AnMayVaa/Sentry/docs/NSC_Project_Report.md

# NSC 2026 Project Report: CSI Fall Detection System (Sentry)

This document tracks the progress, methodologies, conflicts, and engineering solutions for the Sentry project. It serves as a master log for the 28th National Software Contest (NSC) documentation.

---

## Phase 1: Hardware Setup & Data Extraction
**Goal**: Establish a stable Wi-Fi connection between two ESP32 modules and extract raw Channel State Information (CSI) subcarriers in real-time.

*   **Approach**: We configured the Transmitter (Tx) node to continuously inject 802.11 QoS Data packets at 30Hz using the connectionless ESP-NOW protocol. This forces the hardware to use the 54 Mbps OFDM rate, ensuring the radio waves physically contain the 52 usable CSI subcarriers. The Receiver (Rx) node listens in Promiscuous mode, filters by MAC address, and streams the payload over USB. A Python PyQt6 GUI was built to graph the wave amplitudes in real-time.
*   **Conflict**: The ESP32 Rx node kept crashing and rebooting with a `Task watchdog got triggered` error. 
*   **Solution**: The UART serial port at standard `115200` baud was too slow to print 52 floats at 30 frames per second, causing a buffer overflow. We solved this by forcing the UART baud rate to `460800` in both the `sdkconfig` and `rx_main.c` firmware, allowing high-speed, crash-free data streaming.

---

## Phase 2: Machine Learning Fall Detection
**Goal**: Train an Artificial Intelligence model to mathematically detect human falls using the invisible Wi-Fi radio waves.

*   **Approach**: We recorded three CSV datasets (`static.csv`, `walking.csv`, `falling.csv`). We built a feature extraction script (`train_model.py`) to slice the data into 1.5-second windows and calculate mathematical features (Variance, Standard Deviation, Rate of Change). We trained a Random Forest Classifier using `scikit-learn`.
*   **Conflict 1 (Physics)**: Initially, the AI classified falls as "Static". This happened because the physical fall was recorded *behind* the antenna's Line-of-Sight, meaning the Wi-Fi waves didn't hit the body. 
*   **Solution 1**: We re-recorded the falls directly between the two antennas, providing the AI with massive variance spikes.
*   **Conflict 2 (Data Labeling)**: The AI started predicting "Fall" when the user was just walking. This occurred because `falling.csv` contained seconds of walking and lying still, which corrupted the "Fall" label.
*   **Solution 2**: We engineered an automated Data Cleaner inside `train_model.py` that mathematically sorts the file and isolates *only* the top 15% highest-variance frames (the actual impact moment) to train the model, discarding the rest.
*   **Conflict 3 (UI Flickering)**: Quick hand shakes or jumps caused instant, false-positive "FALL DETECTED" flashes in the UI.
*   **Solution 3**: We implemented a **Temporal Sequence State Machine**. A real fall isn't just an impact—it's an impact *followed by stillness*. The app now detects the impact, flags a "Potential Fall", and waits. If the person continues moving, it's ignored. If the person lies completely still, it locks into a "CONFIRMED FALL". We also linked the UI Threshold slider to the AI, allowing the user to manually override sensitivity.

---

## Phase 3: Emergency Notification System
**Goal**: Instantly alert caregivers or family members when the State Machine confirms a fall, ensuring rapid medical response.

*   **Approach**: We integrated the **LINE Messaging API** because LINE is universally used by Thai families and requires no extra app installation. We engineered `line_notifier.py` to construct and send a "Flex Message"—a beautiful, red emergency UI card displaying the exact time of the fall and a primary button to instantly dial `1669` (Ambulance).
*   **Conflict**: If a person stays on the ground, the Python loop (running at 30 frames per second) would send thousands of API requests to LINE, resulting in a ban for spamming. Furthermore, making API requests blocks the main thread, causing the PyQT6 graphs to lag and freeze.
*   **Solution**: We executed the LINE notification inside a Python `threading.Thread(daemon=True)` so it runs in the background without interrupting the live graphs. We also implemented a 60-second software cooldown timer, ensuring the family receives exactly one clear alert per minute until the situation is resolved.

## Phase 4: Hardware SOS Panic Button
**Goal**: Allow elders to manually trigger an alert if they feel dizzy or sick, bypassing the AI fall detection entirely.

*   **Approach**: We hacked the physical `BOOT` button (GPIO 0) built into the Transmitter ESP32. When pressed, the ESP32 conditionally switches its standard ESP-NOW payload from "CSI_MAGIC" to a special "SOS_BUTTON_PRESSED!" string.
*   **Conflict**: The Receiver (Rx) node is strictly configured to run in Promiscuous Mode to sniff raw Wi-Fi waves for CSI extraction. However, in Promiscuous Mode, the ESP32 MAC layer completely blocks the ESP-NOW layer from receiving packets via the standard `espnow_recv_cb` callback. 
*   **Solution**: We bypassed the MAC layer restriction by using Physics! We reprogrammed the Transmitter to dynamically change its payload size. A normal CSI packet is small (~16 bytes). When the SOS button is pressed, the Transmitter instantly bloats its packet to 150 bytes. Inside the Receiver's raw CSI callback, we monitor `info->rx_ctrl.sig_len`. If a massive wave hits the antenna (>100 bytes), the Receiver instantly recognizes it as an SOS signal without needing to decode the payload, bypassing the ESP-NOW limitation entirely. The Rx node then pipes an "SOS_ALERT" string to the Python App, which forces the State Machine into a Fall State and triggers the LINE API. Furthermore, we programmed the Receiver's local BOOT button to instantly print the same `SOS_ALERT` string, meaning BOTH nodes now act as physical panic buttons.
*   **Conflict 2 (Software)**: The Python background thread silently crashed when parsing the `SOS_ALERT` because the UI callback function expected two mathematical arguments (amplitudes, RSSI), but was only given one string ("SOS").
*   **Solution 2**: We updated the background `SerialReader` thread in `serial_reader.py` to properly intercept the `SOS_ALERT` string and pass a dummy RSSI argument (`"SOS", 0`) to satisfy the UI callback's strict signature, instantly un-freezing the graph and firing the LINE API.

## Phase 1.5: Wireless UDP PC Receiver
**Goal**: Remove the USB cable entirely from the Receiver (Rx) Node, allowing it to send CSI data wirelessly over the home Wi-Fi network directly to the PC via UDP packets.

*   **Approach**: We re-wrote the Rx Node firmware in Arduino IDE to leverage its native Wi-Fi stack. The Rx node continues to use Promiscuous Mode on Channel 6 to sniff CSI from the Tx Node, but instead of streaming over serial, it connects to the home router (Access Point) and broadcasts UDP packets to the Windows PC on Port 5000. We also upgraded the Python PyQt6 GUI to replace `serial_reader.py` with a multi-threaded `udp_reader.py`.
*   **Conflict 1 (Build Environment)**: The manual Windows ESP-IDF terminal encountered strict `PATH` and Python environment alias errors when trying to flash the UDP C code, halting progress.
*   **Solution 1**: We abandoned the rigid ESP-IDF C++ environment for this phase and migrated the Rx Node entirely to an Arduino IDE `.ino` sketch. Because the ESP32 Arduino Core wraps the ESP-IDF natively, we could still import `<esp_wifi.h>` to access the low-level Promiscuous Mode and CSI callback functions, granting the user a frictionless 1-click GUI upload process.
*   **Conflict 2 (The One-Antenna Physics Problem)**: When we flashed the UDP code, the Arduino printed `CSI Sniffing Started!` but failed to receive a single packet from the Tx Node. This happened because the ESP32 only has *one* physical antenna. When `WiFi.begin()` connected the Rx Node to the home router to send UDP packets, the antenna forcibly tuned to the router's channel (e.g., Channel 11). Because the Tx Node was still transmitting on Channel 6, the Rx Node became physically deaf to the Tx Node.
*   **Solution 2**: We logged into the user's home TP-Link Router admin panel and forced the 2.4GHz Wi-Fi band to broadcast strictly on **Channel 6**. This aligned the router, the Tx Node, and the Rx Node on the exact same frequency, instantly restoring the invisible CSI radio wave flow.
*   **Conflict 3 (Type Casting & Mathematical Explosion)**: After solving the channel issue, the Python GUI successfully received UDP packets, but the Amplitude graph jumped violently between 100-300, causing the Variance logic to hit 120+ and constantly trigger false "MOVEMENT" alarms. This occurred because we accidentally defined the CSI payload buffer as `uint8_t` (unsigned) instead of `int8_t` (signed) in the Arduino struct. When the ESP32 printed a negative raw CSI value (e.g., `-5`), it wrapped around and was transmitted via UDP as a massive positive integer (`251`).
*   **Solution 3**: We corrected the struct definition in `Arduino_UDP_Receiver.ino` to use `int8_t buf[128]`. This allowed the `udp.print()` function to properly send negative numbers across the Wi-Fi network. The Python app immediately registered correct amplitudes (0-40) and Variance stabilized back to 0-5.
*   **Conflict 4 (Frame Rate Dilution)**: Even with correct amplitudes, the user had to move extremely aggressively for long periods to trigger a Fall or Movement state. This occurred because the ESP32 only has one physical antenna. In Phase 1.5, the RX Node was forced to rapidly switch its MAC layer between sniffing for CSI (Promiscuous Mode) and transmitting to the router (Station Mode) 30 times a second. Because of this massive transmission overhead, it dropped ~50% of the incoming CSI packets. This reduced the effective frame rate to 10-15 fps, causing the AI's mathematical 45-frame window to stretch from 1.5 seconds out to over 3 seconds, artificially diluting the Standard Deviation (Variance) of quick human movements.
*   **Solution 4**: We implemented a **UDP Packet Batching Optimization** in `Arduino_UDP_Receiver.ino`. Instead of transmitting one UDP packet for every CSI frame received, the ESP32 now queues 5 CSI frames into a memory buffer and transmits them together inside a single UDP packet separated by newline characters (`\n`). This cut the Wi-Fi transmission overhead by 500%, allowing the ESP32 to spend 95% of its airtime listening for CSI. We then upgraded the Python `udp_reader.py` to seamlessly parse multi-line UDP packets. This fully restored the 30Hz frame rate and the hyper-responsiveness of the ML model without requiring hardware upgrades.

## Phase 1.75: Edge-Compute Central Brain & Cloudflare Deployment
**Goal**: Migrate the heavy Machine Learning inference and UI rendering off the local PC and onto a headless Raspberry Pi 5 Edge Server, making the dashboard accessible globally via the internet.

*   **Approach**: We deployed the ESP32 receiver via USB directly to the Raspberry Pi 5. We wrote `headless_brain.py` to act as a Unified Server, binding a Python `http.server` and `websockets` engine to a single port (`8000`). We built a stunning Glassmorphism HTML dashboard (`index.html`) using `Chart.js` to render live data over WebSockets. We then deployed a persistent Docker container running `cloudflare/cloudflared` to expose port `8000` globally through a Cloudflare Tunnel (`csi.ohmpatumwan.com`).
*   **Conflict 1 (Tunnel Gateway Crash)**: When setting up the Cloudflare Tunnel, the Cloudflare dashboard reported the tunnel was "Healthy," but accessing the URL resulted in a `502 Bad Gateway`. This occurred because the `cloudflared` process was running inside an isolated Docker container and attempting to route traffic to `http://localhost:8000`. Since the Docker container has its own isolated network stack, its `localhost` could not reach the Raspberry Pi's host network where the Python server was running.
*   **Solution 1**: We destroyed the container and re-deployed it with the `--network host` flag. This bound the container directly to the Raspberry Pi's physical network stack, allowing the tunnel to successfully bridge internet traffic to the Python application.
*   **Conflict 2 (Web Browser Graphics Lag)**: When the dashboard loaded, the `Chart.js` graphs rendered, but the web browser experienced intense stuttering, micro-pausing, and graphic lag on all devices. This occurred because the Raspberry Pi was aggressively blasting 30 JSON payloads per second over the Cloudflare tunnel, and `Chart.js` attempted to mathematically calculate animation curves between every single incoming data point, completely overloading the browser's rendering thread.
*   **Solution 2**: We implemented a dual-layer optimization. On the backend, we introduced a 15 FPS throttle in the Python WebSocket broadcasting loop, ensuring the ML model continues to process physics internally at 30Hz but only sends UI updates every 0.06 seconds. On the frontend, we injected a hardware-acceleration bypass (`chart.update('none')`) into `Chart.js`, forcefully disabling the heavy animation loop and drawing the raw pixels instantly.
*   **Conflict 3 (Responsive Layout Destruction)**: Viewing the Glassmorphism dashboard on mobile devices or zooming in on a desktop caused extreme layout clipping. The CSS architecture was rigidly locked to `height: 100vh` and `overflow: hidden`, breaking the 52-subcarrier charts and warping the control cards into a giant column of wasted space on iPads.
*   **Solution 3**: We unlocked the main CSS container to `min-height: 100vh`, enabled `overflow-x: auto` on the charts to allow physical swiping/sliding, and added specific `@media` breakpoints. This forces the control cards to densely stack without rigid flex-basis padding, creating a flawless, scrollable experience tailored for iPhones and iPads.
*   **Conflict 4 (Multi-Device Desynchronization & Latency)**: We built a Two-Way hardware control panel in the UI (Connect/Disconnect toggle). However, if a user clicked "Disconnect" on their iPad, their PC dashboard remained frozen with the "Connected" UI state. Furthermore, there was an awkward 1-2 second UI delay when pressing the Connect button because the UI waited for Python to physically initialize the PySerial COM port.
*   **Solution 4**: We completely re-architected the Python backend's state architecture. We programmed a global `broadcast_config()` coroutine that instantly pushes state changes to every single connected WebSocket client (`self.connected_clients`). Now, toggling a setting on a phone perfectly mirrors the update to the desktop instantly. Additionally, we injected Optimistic UI Updates into the frontend. When the user taps a button, it instantly fades out and displays "Connecting...", providing immediate tactile feedback while the backend safely completes the physical hardware negotiation.

## Phase 2: Universal Brain (Wireless UDP & mDNS Auto-Discovery)
**Goal**: Completely eliminate the physical USB cable restriction, allowing the ESP32 Receiver Node to be placed anywhere in the house while still streaming high-speed CSI data to the Raspberry Pi Edge Server.

*   **Approach**: We engineered a "Universal Dashboard" and "Universal ESP32 Firmware." The `headless_brain.py` backend was upgraded to dynamically hot-swap between reading from a physical USB `SerialReader` and a network `UDPReader`. The web dashboard was upgraded with a sleek Mode Switcher pill, allowing the user to seamlessly toggle between [USB Mode] and [Wireless UDP Mode] on the fly without dropping the WebSocket connection.
*   **Conflict 1 (Hardcoded IP Address Risk)**: Initially, the ESP32 Firmware was hardcoded to blast UDP packets to the Raspberry Pi's IP address (`192.168.1.8`). However, if the home router restarted and DHCP assigned a new IP to the Pi, the ESP32 would blast packets into the void, completely breaking the system.
*   **Solution 1**: We implemented an **mDNS (Multicast DNS) Auto-Discovery Resolver** using `<ESPmDNS.h>`. Upon boot, the ESP32 queries the local network for the Raspberry Pi's hostname (`OhmPatumwan.local`). Once the Pi responds, the ESP32 dynamically locks onto its current IP address and begins streaming. This makes the ESP32 permanently immune to DHCP IP changes.
*   **Conflict 2 (Firmware Fragmentation)**: Switching between Phase 1.75 (USB) and Phase 2 (UDP) required the user to constantly open the Arduino IDE and re-flash the ESP32 microcontroller with different codebases.
*   **Solution 2**: We engineered a **Universal Firmware** (`Arduino_UDP_Receiver.ino`). The ESP32 now processes the high-speed CSI packets and simultaneously prints them to the physical USB serial port AND blasts them over the Wi-Fi UDP network at the exact same time. The user flashes the ESP32 one final time, after which the hardware permanently supports both modes.

## Phase 3: "God Firmware", Home Router TX & Zero-Lag Architecture
**Goal**: Integrate a Home Router as the primary Wi-Fi wave transmitter to eliminate the need for a dedicated TX ESP32, and mathematically optimize the full pipeline to achieve zero-lag, 30fps real-time inference.

*   **Approach**: We developed the `Phase3_Router_as_TX` pipeline, which repurposes the existing home Wi-Fi router to blanket the room with OFDM Wi-Fi waves. The ESP32 (flashed with `Phase3_God_Firmware.ino`) passively sniffs these ambient waves. The Python backend stimulates the router by sending persistent UDP pings over Wi-Fi.
*   **Conflict 1 (ESP32 Serial Bottleneck)**: The system experienced extreme processing lag (~167ms delays). The ESP32 was artificially queueing CSI packets, and its blocking `Serial.print()` character-by-character UART output completely bottlenecked the CPU.
*   **Solution 1**: We refactored the ESP32 firmware into the "God Firmware". We stripped out the packet-batching delay and replaced the slow `Serial.print()` loop with an ultra-efficient, single-call `Serial.write()` that dumps a pre-formatted memory buffer instantly. This reduced hardware latency to near-zero.
*   **Conflict 2 (Python ML Hot-Path Overhead)**: The Raspberry Pi's ML inference fell further and further behind real-time, accumulating an infinite backlog of unprocessed frames. This occurred because the `headless_brain.py` hot-path created and destroyed Pandas `DataFrame` objects 30 times a second.
*   **Solution 2**: We completely eliminated Pandas from the real-time loop. We engineered `extract_features_np` to perform high-speed math directly on native NumPy arrays, and implemented a thread-safe frame-dropping mechanism (`self._processing` lock) that intelligently skips frames instead of queuing them, ensuring the ML model never falls behind real-time.
*   **Conflict 3 (Browser Render Jank)**: The web dashboard lagged and stuttered because `Chart.js` tried to forcefully repaint the DOM on every single incoming WebSocket message (30Hz).
*   **Solution 3**: We implemented a frame-buffering system in JavaScript. The incoming WebSocket data is decoupled from the UI thread, and we utilize the browser's native `requestAnimationFrame` API to batch chart updates smoothly into the hardware vsync cycle (60fps).
*   **Conflict 4 (NumPy JSON Serialization Crash)**: The Python WebSocket server would sporadically crash and systemd would auto-restart it, causing the dashboard to continuously disconnect and reconnect. The `scikit-learn` Random Forest prediction returned a NumPy `int32` datatype, which standard Python `json.dumps()` could not serialize.
*   **Conflict 5 (Chart.js Memory Leak)**: If the dashboard was left open for long periods, the web browser gradually consumed excessive RAM, causing intense Garbage Collection (GC) pauses and frontend lag.
*   **Solution 5**: We isolated the leak to the 52-subcarrier graph updates. Chart.js was destroying and recreating 52 internal `_meta` DOM objects 15 times a second because we assigned a brand new array reference each frame. We refactored the JavaScript to mutate the existing array in-place (`rawData[i] = new_value`), allowing Chart.js to infinitely recycle its objects, achieving zero memory buildup.

## Phase 4: Multi-Node Architecture & Stability Overhaul
**Goal**: Upgrade the single-room architecture to support an infinite number of Receiver (RX) Nodes across an entire house (e.g., Living Room, Bath Room), scaling the dashboard to visualize and process multi-room CSI data concurrently.

*   **Approach**: We re-architected `headless_brain.py` and the `dashboard/index.html` UI to operate dynamically using a `activeNodes` dictionary instead of hardcoded single-instance elements, allowing the UI to mathematically scale to however many ESP32s are connected. 
*   **Conflict 1 (Data Merging)**: Connecting two ESP32s resulted in their data completely overwriting and colliding with each other on the dashboard. This occurred because both boards output the identical hardcoded `Location: Bath Room` string in their Arduino C++ print statements.
*   **Solution 1**: We implemented a unique ID wrapper in the backend. When raw data enters Python, the `data_received` function dynamically prefixes the payload string with the physical interface ID (e.g. `[COM3]` or `[UDP_5000]`). This allowed the system to logically separate the physics of the two identical boards into two distinct UI blocks without requiring the user to re-flash the hardware firmware with custom names.
*   **Conflict 2 (Zombie Chart Memory Leak)**: If an ESP32 disconnected, its block disappeared. However, when it reconnected, the line graph flickered wildly and drew lines backward. This occurred because destroying the HTML block did not clear the underlying `Chart.js` canvas context from the browser's memory, creating "Zombie Charts" that cross-wired new incoming data with old data.
*   **Solution 2**: We wrapped the HTML rendering into a structured JavaScript `NodeCard` class. We added a strict `destroy()` method that explicitly purges the `Chart.js` object before deleting the HTML node, permanently preventing memory corruption upon reconnection.
*   **Conflict 3 (ESP32 Network Fragmentation & Crashes)**: Over long periods, the nodes exhibited extreme lag (causing the "Temporal Variance" UI number to stutter) and occasionally disappeared from the dashboard entirely. This occurred because the Python backend was constantly broadcasting "PING" strings to the ESP32's listening UDP port to stimulate the network. The poor microcontrollers were receiving 10 UDP packets a second, which fragmented their small heaps as they attempted to parse them, causing lag and eventual memory crashes.
*   **Solution 3**: We stripped the destructive PING command from the codebase. Instead, we directed the Python script to blindly broadcast an empty pulse to a null port (`5001`) over the entire subnet `255.255.255.255`. This successfully forces the Home Router to emit Wi-Fi traffic without burdening the ESP32s, resulting in flawless 24/7 stability.
*   **Conflict 4 (UDP Mode Blindness)**: When connecting multiple ESP32s over UDP, the user had to manually toggle the UI "Transmitter Target" button back and forth to get the ESP32s to configure themselves. This occurred because Python's `udp_reader.py` did not know the IP address of the newly connected ESP32s until *after* they had successfully sent their first packet, making it impossible to send them the initial configuration command.
*   **Solution 4**: We upgraded the UDP command delivery system to use Socket Subnet Broadcasting. When the user connects, Python now shouts the command configuration (`MODE_ROUTER` or `MODE_TX_NODE`) to `255.255.255.255`. Any ESP32 on the network instantly receives and configures itself without needing to establish a prior handshake, creating a zero-friction connection experience.
*   **Conflict 5 (Variance Graph Clipping)**: The Variance Chart completely broke (appearing blank or not updating) when the user made a large movement. This was simply because the Chart.js Y-Axis ceiling was hardcoded to `max: 20`. If the physics variance spiked to 50, the line was physically drawn off-screen.
*   **Solution 5**: We migrated the rigid `max: 20` parameter to `suggestedMax: 20`. This ensures the chart stays perfectly scaled during static periods, but dynamically expands its visual boundaries if violent movements occur, guaranteeing the blue line is always visible.
*   **Conflict 6 (Global Shared Limitations)**: The single "Sensitivity Threshold" slider applied uniformly to all rooms. A high threshold in a small Bath Room might be appropriate, but it ruined the detection algorithm for a massive Living Room.
*   **Solution 6**: We stripped the global slider from the top control panel. We injected a miniature HTML range slider into the `NodeCard` template itself. We then bound these UI sliders to a dedicated `threshold` variable inside the Python `NodeState` dictionary. Now, every single room/ESP32 has a strictly isolated AI trigger threshold that can be perfectly tuned to its physical environment.
*   **Conflict 7 (Hardware Connection Polling)**: The dashboard required a manual refresh to detect newly plugged-in USB COM Ports.
*   **Solution 7**: We injected an asynchronous `_poll_com_ports` background thread into `headless_brain.py` that queries `serial.tools.list_ports` every 2 seconds. When it detects a hardware state change, it automatically fires a WebSocket config payload to the dashboard, providing an instant, real-time "hot plug" UI experience.

---
*Document will be updated as new phases are completed.*
