AnMayVaa/Sentry/Phase8_Next_Phase/previews/overview/index.html

Wi-Fi fall detector · next phase

# A fall or an SOS now rings in every room.

Phase 8 adds a caregiver alert station, a hold-to-SOS button on the RX node, and printable boxes for both. A fall still sends a LINE card. Now the caregiver also hears it in the house.

2 shold the button for SOS

Allstations ring at once

0Pi needed for an SOS to ring

RX node box with antenna, button and LED

RX node

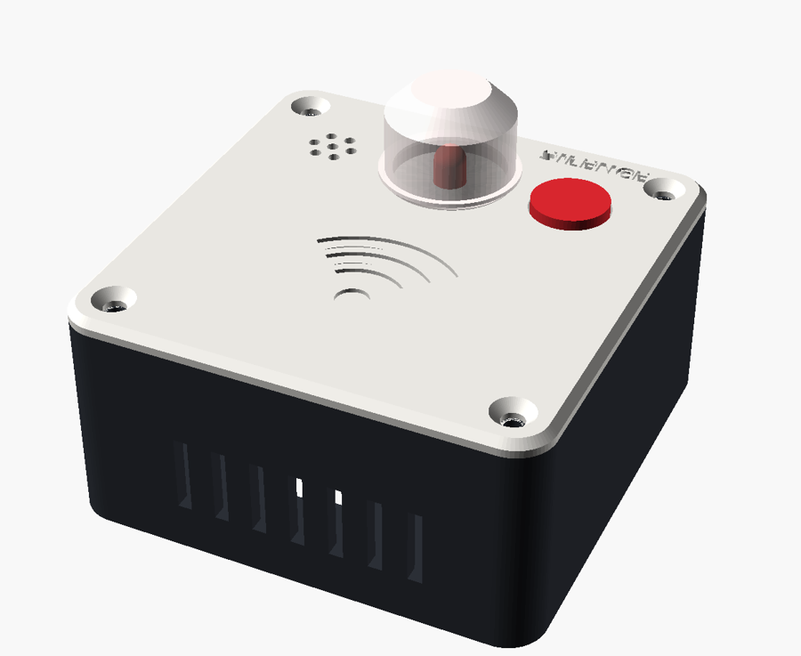
[picture p1: Phase8_Next_Phase/previews/overview/alert_station_assembled.png]
Alert station box with light dome and button


Alert station

## How an alert travels

## FALL When someone falls

1. The RX node streams Wi-Fi CSI to the Pi about 30 times a second.
2. The Pi's model sees the impact, then stillness, and calls it a fall.
3. The caregiver gets the red LINE fall card with Call 1669 and Silence.
4. Every alert station and the RX node start fast beeping until silenced.

## SOS When someone needs help

1. They hold the RX button for 2 seconds. The LED lights while they hold.
2. 3 quick chirps confirm it went out. The node sends it 3 times in case a packet drops.
3. The alert stations play SOS in Morse, straight from the node.
4. The Pi sends a separate 🆘 LINE card and the dashboard shows SOS PRESSED!

## What the button does

Device | When | Press | Result
RX node | Idle | Hold 2 s | SOS to Pi and stations
| Idle | Short | Status chirp (1 = Wi-Fi OK)
| Ringing | Any | Silences this node at once; no SOS
Alert station | Ringing | Any | Silences this station
| Idle | Hold 2 s | Self-test beep
| Idle | Short | Status chirp

## What each sound means

bars drawn to scale · 1.6 s shown

## Wiring (same on both devices)

GPIO 2 ──[220 Ω]──▶|── GND red LED GPIO 4 ──── (+) buzzer (–) ── GND active buzzer GPIO 17 ──── button ──── GND 12×12 switch (internal pull-up)

220 Ω gives the LED about 6 mA. For a louder buzzer in a noisy hall, drive it from 5 V through an S8050 transistor with a 1 kΩ base resistor.

## Antennas

Board

ESP32-WROOM-32U (IPEX socket)

RX node

2.4 GHz antenna outside on SMA: helps CSI sensing

Alert station

no outside antenna; keep the small one plugged in inside

Why inside

a 32U has no built-in antenna, so it needs one to join Wi-Fi

Option

alert_station_base_antenna_hole.stl if you want it outside

## The boxes

Size

72.8 × 72.8 × 35.8

mm, same for both devices, so one stand and one screw set fit both

Print

PLA or PETG · 0.2 mm layers · 3 walls · 20 % infill · no supports · fits a 220 mm bed

Mount

Table (rubber feet) · wall (2 keyholes, 32 mm apart) · 20° desk stand · tape

No brand name on any part: the lid only carries a Wi-Fi mark and the button label. Turn the boxes around in the 3D viewer.

35 / 35

### Pi tests

SOS copies count once, SOS never blocks a fall alert, both message formats parse.

31 / 31

### Firmware tests

The real sketches run on a PC with simulated buttons, buzzer, time and Wi-Fi.

9 / 9

### Print files checked

Closed and manifold, no supports, and no parts collide when assembled.

## Demo-day run

- Power the Pi, then the stations, then the RX node. Each beeps twice on Wi-Fi.
- Hold the RX button 2 s: chirps, Morse on the stations, LINE SOS card.
- Press each button to silence it.
- Do a fall: fast beeps everywhere and the LINE fall card. Tap Silence.
- Unplug the Pi and hold the RX button again: the stations still ring.

## Before you print and flash

- Compile both sketches once in the Arduino IDE (ESP32 core 3.x).
- Measure the ESP32 board: the box expects 52 × 28.5 mm.
- Print one lid first and check the button and LED fit.
- Put your Wi-Fi in secrets.h; it never goes to GitHub.
