AnMayVaa/Sentry/docs/images/CSI_Signal_Signatures.png

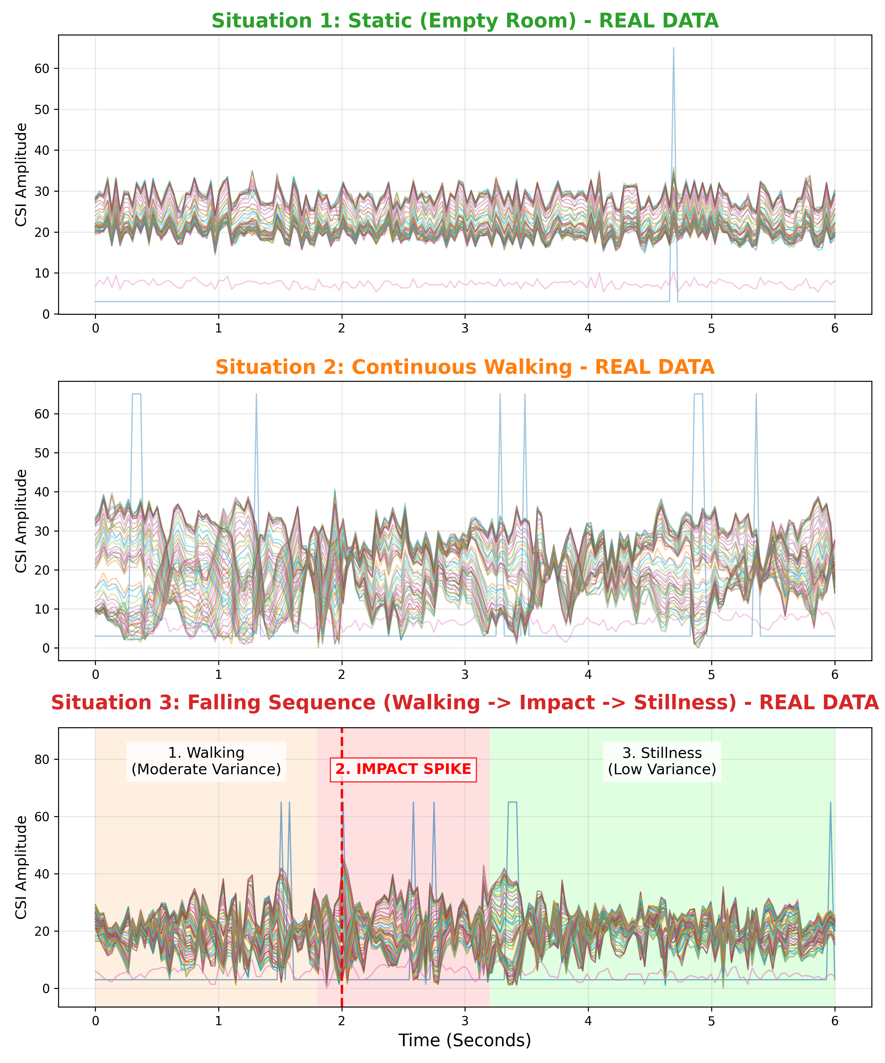
docs/images/CSI_Signal_Signatures.png
