AnMayVaa/Sentry/docs/images/image8_signature.png

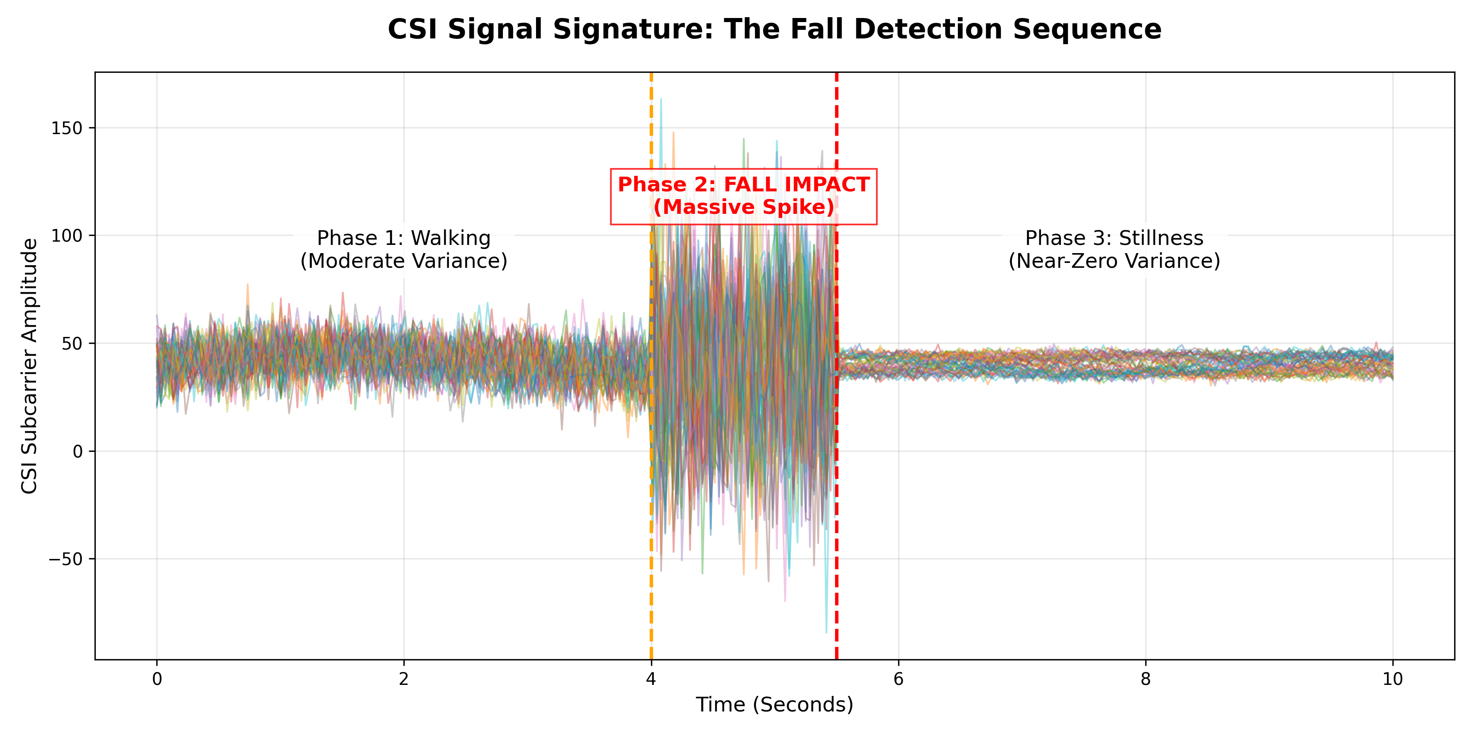
docs/images/image8_signature.png
