AnMayVaa/Sentry/docs/images/LINE_Mockup_1669.png

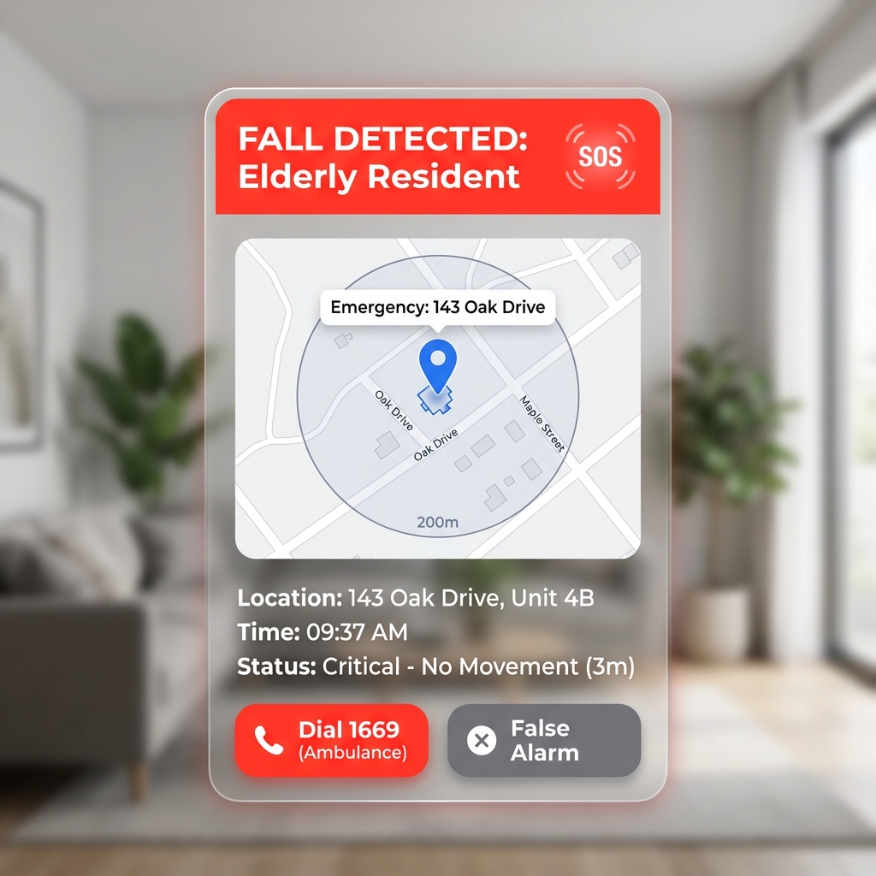
docs/images/LINE_Mockup_1669.png
