AnMayVaa/Sentry/Phase8_Next_Phase/enclosures/png/rx_node_exploded.png

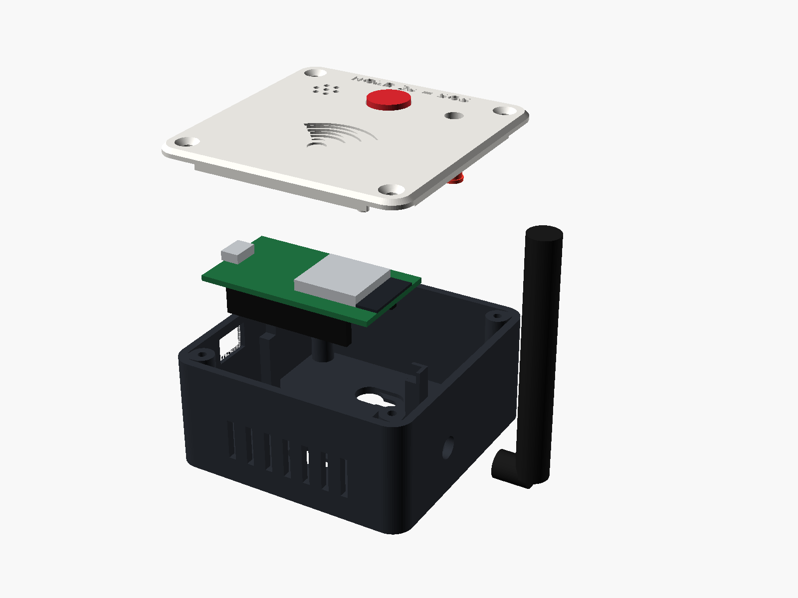
Phase8_Next_Phase/enclosures/png/rx_node_exploded.png
