AnMayVaa/Sentry/Phase8_Next_Phase/enclosures/stl/button_shim_1mm.stl

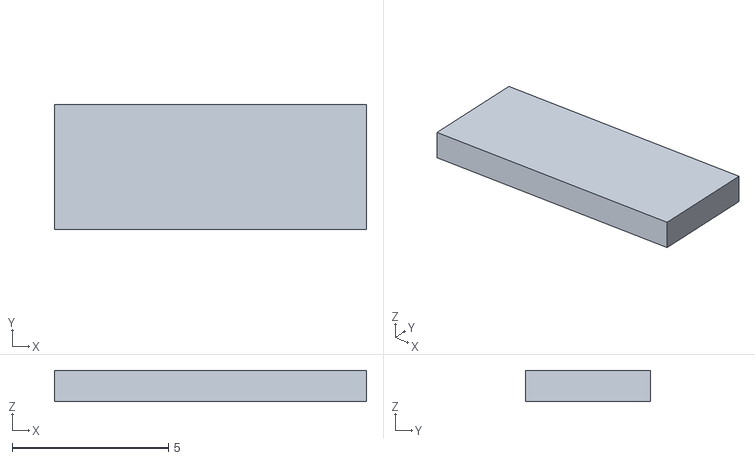
[picture p6: CAD file, 2026-11-09]
Phase8_Next_Phase/enclosures/stl/button_shim_1mm.stl
10.0 x 4.00 x 1.00
