AnMayVaa/Sentry/Phase8_Next_Phase/enclosures/stl/rx_node_lid.stl

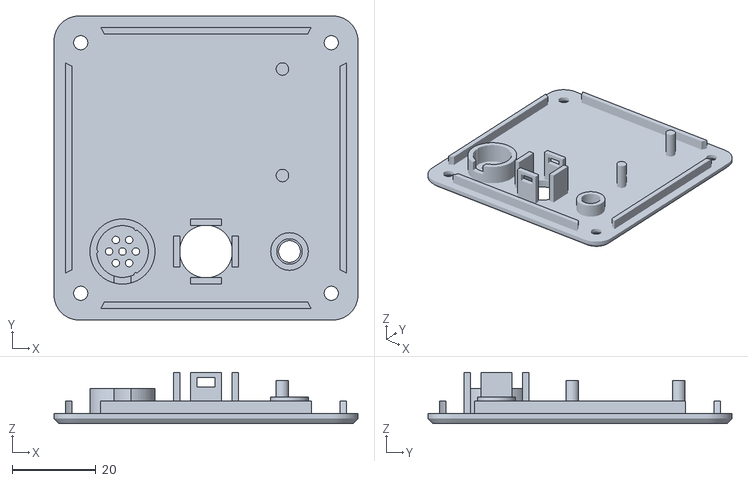
[picture p7: CAD file, 2026-11-09]
Phase8_Next_Phase/enclosures/stl/rx_node_lid.stl
72.8 x 72.8 x 12.3
