AnMayVaa/Sentry/Sentry_NSC_sourcecode/main.py

import sys
import locale
locale.setlocale(locale.LC_ALL, 'C') # Force English numerals

print("Starting main.py")
try:
    from PyQt6.QtWidgets import QApplication, QMainWindow, QVBoxLayout, QHBoxLayout, QWidget, QPushButton, QComboBox, QLabel, QGroupBox, QCheckBox
    from PyQt6.QtCore import QTimer
    import pyqtgraph as pg
    import numpy as np
    import serial.tools.list_ports
    from serial_reader import SerialReader
    from udp_reader import UDPReader
    print("Imported everything")
except Exception as e:
    print(f"Import error: {e}")
    sys.exit(1)

class CSIVisualizerApp(QMainWindow):
    def __init__(self):
        super().__init__()
        self.setWindowTitle("CSI Fall Detection Control App")
        self.resize(1000, 600)
        
        self.reader = None
        self.latest_data = None
        self.ml_model = None
        self.line_alerts_enabled = True
            
        self.prediction_history = []
        self.fall_latch_time = 0
        
        self.variance_buffer_size = 300 # 10 seconds at 30fps
        self.variance_history = np.zeros(self.variance_buffer_size)
        
        self.init_ui()
        
        # Timer for UI updates
        self.timer = QTimer()
        self.timer.timeout.connect(self.update_plot)
        self.timer.start(30) # ~33fps refresh rate
        
    def init_ui(self):
        from PyQt6.QtWidgets import QDoubleSpinBox, QGroupBox, QFrame
        from PyQt6.QtCore import Qt
        
        central_widget = QWidget()
        self.setCentralWidget(central_widget)
        main_layout = QHBoxLayout(central_widget)
        
        # --- LEFT PANEL: CONTROLS ---
        left_panel = QVBoxLayout()
        
        # 1. Connection Group
        conn_group = QGroupBox("1. Hardware Connection")
        conn_group.setStyleSheet("QGroupBox { font-weight: bold; }")
        conn_layout = QVBoxLayout()
        
        type_row = QHBoxLayout()
        type_row.addWidget(QLabel("Type:"))
        self.type_combo = QComboBox()
        self.type_combo.addItems(["Serial (COM)", "UDP (Wi-Fi)"])
        self.type_combo.currentTextChanged.connect(self.on_type_changed)
        type_row.addWidget(self.type_combo)
        conn_layout.addLayout(type_row)
        
        port_row = QHBoxLayout()
        self.lbl_port = QLabel("COM Port:")
        port_row.addWidget(self.lbl_port)
        self.port_combo = QComboBox()
        self.refresh_ports()
        port_row.addWidget(self.port_combo)
        
        self.btn_refresh = QPushButton("Refresh")
        self.btn_refresh.clicked.connect(self.refresh_ports)
        port_row.addWidget(self.btn_refresh)
        conn_layout.addLayout(port_row)
        
        self.btn_connect = QPushButton("Connect Receiver")
        self.btn_connect.setMinimumHeight(35)
        self.btn_connect.setStyleSheet("background-color: #2980b9; color: white; font-weight: bold; border-radius: 4px;")
        self.btn_connect.clicked.connect(self.toggle_connection)
        conn_layout.addWidget(self.btn_connect)
        
        self.lbl_status = QLabel("Status: Disconnected")
        self.lbl_status.setAlignment(Qt.AlignmentFlag.AlignCenter)
        conn_layout.addWidget(self.lbl_status)
        conn_group.setLayout(conn_layout)
        left_panel.addWidget(conn_group)
        
        # 2. Experiment / Recording Group
        rec_group = QGroupBox("2. Data Collection")
        rec_group.setStyleSheet("QGroupBox { font-weight: bold; }")
        rec_layout = QVBoxLayout()
        
        self.btn_record = QPushButton("Start Recording CSV")
        self.btn_record.setMinimumHeight(35)
        self.btn_record.clicked.connect(self.toggle_recording)
        self.btn_record.setEnabled(False)
        self.is_recording = False
        rec_layout.addWidget(self.btn_record)
        rec_group.setLayout(rec_layout)
        left_panel.addWidget(rec_group)
        
        # 3. AI Monitor Group
        ai_group = QGroupBox("3. AI Fall Detection Monitor")
        ai_group.setStyleSheet("QGroupBox { font-weight: bold; }")
        ai_layout = QVBoxLayout()
        
        thresh_row = QHBoxLayout()
        thresh_row.addWidget(QLabel("Variance Threshold:"))
        self.spin_threshold = QDoubleSpinBox()
        self.spin_threshold.setRange(0.1, 20.0)
        self.spin_threshold.setSingleStep(0.1)
        self.spin_threshold.setValue(2.0)
        self.current_threshold = 2.0
        self.spin_threshold.valueChanged.connect(self.update_threshold)
        thresh_row.addWidget(self.spin_threshold)
        ai_layout.addLayout(thresh_row)
        
        self.history = []
        self.is_moving = False
        
        self.lbl_movement = QLabel("STATIC")
        self.lbl_movement.setAlignment(Qt.AlignmentFlag.AlignCenter)
        self.lbl_movement.setStyleSheet("background-color: #27ae60; color: white; font-size: 22px; font-weight: bold; padding: 15px; border-radius: 5px;")
        ai_layout.addWidget(self.lbl_movement)
        ai_group.setLayout(ai_layout)
        left_panel.addWidget(ai_group)
        
        # Quick Guide
        guide_label = QLabel(
            "<h3>Quick Guide</h3>"
            "<ul>"
            "<li><b>Connect</b> to the RX node (ESP32).</li>"
            "<li><b>Threshold:</b> Controls sensitivity between Static and Movement.</li>"
            "<li><b>Recording:</b> Saves CSI data to <code>/data</code> folder for ML training.</li>"
            "<li><b>Test Fall:</b> Walk, Fall, then lay completely still for 3s to trigger SOS!</li>"
            "</ul>"
        )
        guide_label.setWordWrap(True)
        guide_label.setStyleSheet("background-color: #f1f2f6; padding: 10px; border-radius: 5px; margin-top: 10px;")
        left_panel.addWidget(guide_label)
        
        # 4. Settings & Models Group
        settings_group = QGroupBox("4. Settings & Models")
        settings_group.setStyleSheet("QGroupBox { font-weight: bold; }")
        settings_layout = QVBoxLayout()
        
        self.chk_line = QCheckBox("Enable LINE Alerts")
        self.chk_line.setChecked(True)
        self.chk_line.stateChanged.connect(self.toggle_line_alerts)
        settings_layout.addWidget(self.chk_line)
        
        model_row = QHBoxLayout()
        model_row.addWidget(QLabel("Model:"))
        self.model_combo = QComboBox()
        self.model_combo.currentTextChanged.connect(self.load_selected_model)
        model_row.addWidget(self.model_combo)
        
        self.btn_refresh_models = QPushButton("Refresh")
        self.btn_refresh_models.clicked.connect(self.refresh_models)
        model_row.addWidget(self.btn_refresh_models)
        
        settings_layout.addLayout(model_row)
        settings_group.setLayout(settings_layout)
        left_panel.addWidget(settings_group)
        
        left_panel.addStretch()
        main_layout.addLayout(left_panel, 1) # 1 part width for controls
        
        # Populate models at startup
        self.refresh_models()
        
        # --- RIGHT PANEL: PLOTS ---
        plot_layout = QVBoxLayout()
        
        self.variance_plot = pg.PlotWidget(title="Live Motion Index (Temporal Variance)")
        self.variance_plot.setYRange(0, 30) # Scale adjusted for variance
        self.variance_plot.setLabel('left', 'Variance')
        self.variance_plot.showGrid(x=True, y=True, alpha=0.3)
        self.variance_curve = self.variance_plot.plot(pen=pg.mkPen(color='r', width=2))
        
        from PyQt6.QtCore import Qt
        self.thresh_line = pg.InfiniteLine(angle=0, pen=pg.mkPen('y', width=2, style=Qt.PenStyle.DashLine))
        self.thresh_line.setValue(2.0)
        self.variance_plot.addItem(self.thresh_line)
        plot_layout.addWidget(self.variance_plot)
        
        self.plot_widget = pg.PlotWidget(title="Raw CSI Subcarriers (52 Ch Snapshot)")
        self.plot_widget.setYRange(0, 60) 
        self.plot_widget.setLabel('left', 'Amplitude')
        self.plot_widget.showGrid(x=True, y=True, alpha=0.3)
        self.curve = self.plot_widget.plot(pen=pg.mkPen(color='c', width=2))
        plot_layout.addWidget(self.plot_widget)
        
        main_layout.addLayout(plot_layout, 3) # 3 parts width for plot

    def update_threshold(self, value):
        self.current_threshold = value
        if hasattr(self, 'thresh_line'):
            self.thresh_line.setValue(value)

    def toggle_line_alerts(self, state):
        self.line_alerts_enabled = (state == 2)

    def refresh_models(self):
        import os
        self.model_combo.blockSignals(True)
        self.model_combo.clear()
        if not os.path.exists("models"):
            os.makedirs("models", exist_ok=True)
            
        pkl_files = [f for f in os.listdir("models") if f.endswith(".pkl")]
        if pkl_files:
            self.model_combo.addItems(pkl_files)
            self.model_combo.blockSignals(False)
            self.load_selected_model(self.model_combo.currentText())
        else:
            self.model_combo.addItem("No models found")
            self.ml_model = None
            self.model_combo.blockSignals(False)
            
    def load_selected_model(self, model_name):
        import joblib
        import os
        if model_name and model_name != "No models found":
            try:
                path = os.path.join("models", model_name)
                self.ml_model = joblib.load(path)
                print(f"Loaded ML model: {model_name}")
            except Exception as e:
                print(f"Could not load ML model: {e}")
                self.ml_model = None

    def refresh_ports(self):
        self.port_combo.clear()
        ports = serial.tools.list_ports.comports()
        for p in ports:
            self.port_combo.addItem(p.device)
            
    def data_received(self, amplitudes, rssi):
        # --- PHASE 4: SOS BUTTON INTERRUPT ---
        import time
        if isinstance(amplitudes, str) and amplitudes == "SOS":
            self.current_prediction = 2 # Force Fall State
            self.fall_latch_time = time.time()
            self.lbl_movement.setText("STATUS: ๐จ SOS BUTTON PRESSED! ๐จ")
            self.lbl_movement.setStyleSheet("color: red; font-size: 32px; font-weight: bold;")
            
            # Trigger LINE Alert for SOS
            if getattr(self, 'line_alerts_enabled', True):
                current_time = time.time()
                if not hasattr(self, 'last_line_alert_time'):
                    self.last_line_alert_time = 0
                if current_time - self.last_line_alert_time > 60.0:
                    import threading
                    from line_notifier import send_fall_alert
                    threading.Thread(target=send_fall_alert, daemon=True).start()
                    self.last_line_alert_time = current_time
            return

        # Callback from SerialReader thread
        self.latest_data = amplitudes
        
        # Movement Detection Logic
        self.history.append(amplitudes)
        if len(self.history) > 45: # 45 frames = 1.5 seconds at 30Hz
            self.history.pop(0)
            
            current_variance = 0.0
            
            if hasattr(self, 'ml_model') and self.ml_model is not None:
                import pandas as pd
                from train_model import extract_features
                
                # ML Inference
                hist_arr = np.array(self.history)
                df_window = pd.DataFrame(hist_arr)
                features = extract_features(df_window)
                raw_pred = self.ml_model.predict([features])[0]
                
                current_variance = features[0]
                
                # --- SENSITIVITY OVERRIDE ---
                # features[0] is the mean standard deviation (variance).
                # If the physical variance exceeds the UI Threshold slider, force the app out of STATIC!
                if current_variance > self.current_threshold and raw_pred == 0:
                    raw_pred = 1 # Force MOVEMENT
                
                # Debounce Logic
                self.prediction_history.append(raw_pred)
                if len(self.prediction_history) > 15: # 0.5 seconds buffer
                    self.prediction_history.pop(0)
                    
                from collections import Counter
                import time
                mode_pred = Counter(self.prediction_history).most_common(1)[0][0]
                
                current_time = time.time()
                
                # Sequence State Machine: A real fall is IMPACT (2) followed by STATIC (0)
                if mode_pred == 2:
                    # Record the time of the high-impact event (but don't alert yet!)
                    if not hasattr(self, 'potential_fall_time'):
                        self.potential_fall_time = current_time
                    self.potential_fall_time = current_time
                    
                # Check if we had an impact in the last 3 seconds, AND the user is now completely STILL (0)
                if hasattr(self, 'potential_fall_time'):
                    if (current_time - self.potential_fall_time < 3.0) and mode_pred == 0:
                        self.fall_latch_time = current_time # CONFIRMED FALL!
                        
                        # --- PHASE 3: LINE NOTIFICATION ---
                        if getattr(self, 'line_alerts_enabled', True):
                            if not hasattr(self, 'last_line_alert_time'):
                                self.last_line_alert_time = 0
                                
                            # 60 second cooldown to prevent API spam
                            if current_time - self.last_line_alert_time > 60.0:
                                import threading
                                from line_notifier import send_fall_alert
                                # Run in a background thread so it doesn't freeze the UI!
                                threading.Thread(target=send_fall_alert, daemon=True).start()
                                self.last_line_alert_time = current_time
                        
                # UI Latching: Keep the FALL alert on screen for 3 seconds
                if time.time() - self.fall_latch_time < 3.0:
                    self.current_prediction = 2
                else:
                    # If they are currently impacting/shaking (2) but haven't gone static yet, 
                    # just show MOVEMENT (1) to prevent flickering false alarms.
                    self.current_prediction = 1 if mode_pred == 2 else mode_pred
            else:
                # Fallback heuristic
                hist_arr = np.array(self.history)
                std_devs = np.std(hist_arr, axis=0)
                mean_std = np.mean(std_devs)
                current_variance = mean_std
                
                if mean_std > self.current_threshold:
                    self.current_prediction = 1 # Movement
                else:
                    self.current_prediction = 0 # Static
                
            # Update visual variance buffer
            self.variance_history[:-1] = self.variance_history[1:]
            self.variance_history[-1] = current_variance
                
        # If recording, save to file
        if self.is_recording and hasattr(self, 'csv_file') and not self.csv_file.closed:
            try:
                # Convert the amplitudes array to a comma-separated string
                line = ",".join(f"{amp:.2f}" for amp in amplitudes)
                import time
                self.csv_file.write(f"{time.time()},{rssi},{line}\n")
            except Exception as e:
                print(f"Error writing to CSV: {e}")

    def update_plot(self):
        if self.latest_data is not None:
            self.curve.setData(self.latest_data)
        self.variance_curve.setData(self.variance_history)
            
        if hasattr(self, 'current_prediction'):
            if self.current_prediction == 2:
                self.lbl_movement.setText("FALL DETECTED!")
                self.lbl_movement.setStyleSheet("background-color: red; color: white; font-size: 24px; font-weight: bold; padding: 10px;")
            elif self.current_prediction == 1:
                self.lbl_movement.setText("MOVEMENT")
                self.lbl_movement.setStyleSheet("background-color: orange; color: black; font-size: 20px; font-weight: bold; padding: 5px;")
            else:
                self.lbl_movement.setText("STATIC")
                self.lbl_movement.setStyleSheet("background-color: green; color: white; font-size: 20px; font-weight: bold; padding: 5px;")

    def on_type_changed(self, text):
        is_serial = (text == "Serial (COM)")
        self.lbl_port.setEnabled(is_serial)
        self.port_combo.setEnabled(is_serial)
        self.btn_refresh.setEnabled(is_serial)

    def toggle_connection(self):
        if self.reader and self.reader.running:
            if self.is_recording:
                self.toggle_recording() # Ensure recording stops if we disconnect
            self.reader.disconnect()
            self.btn_connect.setText("Connect")
            self.lbl_status.setText("Disconnected")
            self.btn_record.setEnabled(False)
        else:
            conn_type = self.type_combo.currentText()
            if conn_type == "Serial (COM)":
                port = self.port_combo.currentText()
                if not port:
                    return
                self.reader = SerialReader(port, 460800, self.data_received)
                status_text = f"Connected to {port}"
            else:
                self.reader = UDPReader(5000, self.data_received)
                status_text = "Listening on UDP 5000"
                
            if self.reader.connect():
                self.btn_connect.setText("Disconnect")
                self.lbl_status.setText(status_text)
                self.btn_record.setEnabled(True)
            else:
                self.lbl_status.setText("Connection Failed")

    def toggle_recording(self):
        import time
        import os
        self.is_recording = not self.is_recording
        if self.is_recording:
            # Create data directory if it doesn't exist
            os.makedirs("data", exist_ok=True)
            filename = f"data/csi_record_{int(time.time())}.csv"
            try:
                self.csv_file = open(filename, "w")
                # Write header: timestamp, rssi, subcarrier_1...subcarrier_52
                headers = ["timestamp", "rssi"] + [f"sub_{i}" for i in range(1, 53)]
                self.csv_file.write(",".join(headers) + "\n")
                
                self.btn_record.setText("Stop Recording")
                self.btn_record.setStyleSheet("background-color: red; color: white;")
                self.lbl_status.setText(f"Recording to {filename}")
            except Exception as e:
                print(f"Failed to open file: {e}")
                self.is_recording = False
        else:
            self.btn_record.setText("Start Recording")
            self.btn_record.setStyleSheet("")
            self.lbl_status.setText(f"Connected to {self.port_combo.currentText()}")
            if hasattr(self, 'csv_file') and not self.csv_file.closed:
                self.csv_file.close()

if __name__ == "__main__":
    import time
    app = QApplication(sys.argv)
    window = CSIVisualizerApp()
    window.show()
    sys.exit(app.exec())
