AnMayVaa/Sentry/Phase5_Alarm_Receiver/Phase5_Alarm_Receiver/Phase5_Alarm_Receiver.ino

// ============================================================
// Phase5_Alarm_Receiver.ino
// Sentry IoT - Physical Fall Alarm Node
//
// Compatible with ESP32 Arduino Core v3.x (new LEDC API)
//
// - Listens for UDP "FALL_ALERT" on port 5001
// - Sends heartbeat "ALARM_READY" broadcast every 5s on port 5002
//   so the Raspberry Pi dashboard can show this device as online
// - Triggers: Red LED blink + scary descending buzzer on fall
// - Graceful: if LED/buzzer not wired, no crash
// ============================================================

#include <WiFi.h>
#include <WiFiUDP.h>

// ---------- CONFIGURATION ----------
const char* WIFI_SSID     = "BUNDAOBUNTAI";
const char* WIFI_PASSWORD = "ohm12345";

const int ALARM_UDP_PORT     = 5005;  // Receive fall alerts from Pi
const int HEARTBEAT_UDP_PORT = 5002;  // Send heartbeats to Pi
const int HEARTBEAT_INTERVAL = 5000;  // ms between heartbeats

const int LED_PIN    = 2;   // Red LED  (220Ω resistor in series)
const int BUZZER_PIN = 4;   // Passive buzzer (100Ω resistor in series)
const int BUTTON_PIN = 17;  // Push button between GPIO 17 and GND (Active LOW)
// -----------------------------------

WiFiUDP udpRx;     // Receive alerts
WiFiUDP udpTx;     // Send heartbeats

unsigned long lastHeartbeat = 0;

// Scary descending frequency sweep
const int NOTE_COUNT = 8;
const int FREQS[NOTE_COUNT]     = {2000, 1700, 1400, 1100, 900, 700, 500, 300};
const int DURATIONS[NOTE_COUNT] = { 120,  120,  120,  120, 150, 150, 180, 300};

// ---- helpers ----
void buzzerTone(int freq) {
  ledcWriteTone(BUZZER_PIN, freq);
}
void buzzerOff() {
  ledcWriteTone(BUZZER_PIN, 0);
}

void sendHeartbeat() {
  String msg = "ALARM_READY:" + WiFi.localIP().toString();
  udpTx.beginPacket(IPAddress(255,255,255,255), HEARTBEAT_UDP_PORT);
  udpTx.print(msg);
  udpTx.endPacket();
  Serial.printf("[ALARM] Heartbeat sent: %s\n", msg.c_str());
}

// ---- Boot setup ----
void setup() {
  Serial.begin(115200);
  Serial.println("\n[ALARM] Sentry Phase 5 - Alarm Receiver Boot");

  pinMode(LED_PIN, OUTPUT);
  digitalWrite(LED_PIN, LOW);
  pinMode(BUTTON_PIN, INPUT_PULLUP);

  ledcAttach(BUZZER_PIN, 2000, 8);
  buzzerOff();

  Serial.printf("[ALARM] Connecting to WiFi: %s\n", WIFI_SSID);
  WiFi.begin(WIFI_SSID, WIFI_PASSWORD);

  int retries = 0;
  while (WiFi.status() != WL_CONNECTED && retries < 30) {
    delay(500);
    Serial.print(".");
    retries++;
  }

  if (WiFi.status() == WL_CONNECTED) {
    Serial.printf("\n[ALARM] WiFi OK! IP: %s\n", WiFi.localIP().toString().c_str());
  } else {
    Serial.println("\n[ALARM] WiFi failed — will retry in loop");
  }

  udpRx.begin(ALARM_UDP_PORT);
  Serial.printf("[ALARM] Listening on UDP port %d\n", ALARM_UDP_PORT);
  Serial.printf("[ALARM] Sending heartbeats on UDP port %d\n", HEARTBEAT_UDP_PORT);
  Serial.println("[ALARM] Alarm Reset Button active on Pin 17.");

  bootBeep();
  sendHeartbeat(); // Send immediately on boot
}

// ---- Main loop ----
void loop() {
  if (WiFi.status() != WL_CONNECTED) {
    Serial.println("[ALARM] WiFi lost, reconnecting...");
    WiFi.reconnect();
    delay(3000);
    return;
  }

  // Send heartbeat every HEARTBEAT_INTERVAL ms
  if (millis() - lastHeartbeat >= HEARTBEAT_INTERVAL) {
    sendHeartbeat();
    lastHeartbeat = millis();
  }

  // Check for fall alert UDP packet
  int packetSize = udpRx.parsePacket();
  if (packetSize > 0) {
    char buf[64];
    int len = udpRx.read(buf, sizeof(buf) - 1);
    if (len > 0) {
      buf[len] = '\0';
      String msg = String(buf);
      msg.trim();
      Serial.printf("[ALARM] UDP received: %s\n", msg.c_str());

      if (msg.startsWith("FALL_ALERT")) {
        Serial.println("[ALARM] FALL DETECTED — triggering continuous alarm!");
        triggerAlarm();
      }
    }
  }

  delay(10);
}

// ---- Full alarm sequence (loops until button on Pin 17 is pressed) ----
void triggerAlarm() {
  while (true) {
    for (int i = 0; i < NOTE_COUNT; i++) {
      // Check if button on GPIO 17 is pressed to stop alarm
      if (digitalRead(BUTTON_PIN) == LOW) {
        buzzerOff();
        digitalWrite(LED_PIN, LOW);
        Serial.println("[ALARM] Button on Pin 17 pressed! Alarm cancelled.");
        delay(250); // Debounce
        return;
      }

      buzzerTone(FREQS[i]);
      digitalWrite(LED_PIN, (i % 2 == 0) ? HIGH : LOW);
      delay(DURATIONS[i]);
    }
  }
}

// ---- 2 short boot beeps ----
void bootBeep() {
  for (int i = 0; i < 2; i++) {
    buzzerTone(1000);
    digitalWrite(LED_PIN, HIGH);
    delay(100);
    buzzerOff();
    digitalWrite(LED_PIN, LOW);
    delay(150);
  }
}
