AnMayVaa/Sentry/(commit log)

2026-05-26 Initial commit for Sentry project: Phase 1-5 complete
    [falling.csv, static.csv, walking.csv]
2026-05-26 Revamp GUI layout, add Quick Guide, fix Thai numeral locale
    [main.py]
2026-05-27 Add Headless Brain for Raspberry Pi Edge Computing
2026-05-27 Fix websockets 16.0 asyncio bug
    [headless_brain.py]
2026-06-24 Restructure project files into phases and add config.json
    [falling.csv, static.csv, walking.csv]
2026-06-24 Update ESP32 code to support Wi-Fi UDP streaming
2026-06-24 Update Central Brain to use UDP wireless protocol
2026-06-24 Update docs, fix int8 bug, implement UDP batching
    [Arduino_UDP_Receiver.ino, headless_brain.py, line_notifier.py, main.py, ml_engine.py, rx_main.c, serial_reader.py]
2026-06-24 Fix websockets v14 crash and optimize 16:9 CSS
    [headless_brain.py]
2026-06-24 Throttle UI broadcast to 15fps to reduce lag, restore strict gatekeeper
2026-06-24 Add disconnect button and fix desktop zoom clipping
    [headless_brain.py]
2026-06-24 Phase 2: Universal Dashboard and ESP32 Firmware
2026-06-24 Fix UDP dest IP
    [Arduino_UDP_Receiver.ino]
2026-06-24 Use mDNS to dynamically resolve Raspberry Pi IP
    [Arduino_UDP_Receiver.ino]
2026-06-25 Fix websockets Headers import
    [headless_brain.py]
2026-06-25 Fix process_request signature for websockets
    [headless_brain.py]
2026-06-25 Apply Phase 2.5 fixes to Phase 3 firmware
    [Phase3_God_Firmware.ino]
2026-06-25 Apply Phase 2.5 false SOS fix to Phase 3 Firmware and add Phase 2.5
    [line_notifier.py, main.py, ml_engine.py, rx_main.c, serial_reader.py, tx_main.c, udp_reader.py]
2026-06-25 Add Heartbeat to fix headless UDP deadlock
    [Phase3_God_Firmware.ino]
2026-06-25 Fix USB Serial: add back Serial.write using efficient single-call buffer
    [Phase3_God_Firmware.ino]
2026-06-25 Fix USB+Router lag: always send UDP pings over Wi-Fi to stimulate router
    [headless_brain.py]
2026-06-25 Performance: eliminate pandas from hot path, add frame skipping, halve ML inference rate
    [headless_brain.py, ml_engine.py]
2026-06-25 Fix variance chart gaps: cache last variance for non-ML frames
    [headless_brain.py]
2026-06-25 Fix progressive lag: decouple broadcast from data processing, fixed 15Hz async loop
    [headless_brain.py]
2026-06-25 Fix NumPy serialization crash by casting to native Python types
    [headless_brain.py]
2026-06-25 Fix UI payload aggregation to display multiple NodeCards simultaneously and handle node timeouts
    [headless_brain.py]
2026-06-25 Fix missing attributes in headless_brain __init__
    [headless_brain.py]
2026-06-25 Fix ws_handler missing port attribute bug
    [headless_brain.py]
2026-06-25 Fix graph block merging for identically named ESP32s, and fix auto-appear on connection by initializing TX mode
    [headless_brain.py]
2026-06-25 Fix UDP reader ID mapping and remove emojis from project
    [headless_brain.py, udp_reader.py]
2026-06-25 Remove Wireless UDP globe emoji
2026-06-26 Fix ESP32 UDP PING crash and UI Variance scaling
    [headless_brain.py, udp_reader.py]
2026-06-27 UI Tweaks: Fix pill button flex alignment and remove simulation tooltips
2026-06-27 Fix HTTP caching issues for dashboard
    [headless_brain.py]
2026-06-27 UI Tweaks: Remove simulation buttons entirely
2026-06-29 Debug: fix sim_locked so state persists, FALL fires LINE, remove LINE button
    [headless_brain.py]
2026-06-29 Debug: fix sim_locked skips ML, state persists, FALL label, no back button, no rebuild wipe
    [headless_brain.py]
2026-06-29 Fix: STATIC lock persists, release_sim unlocks, LINE cooldown 5s for debug
    [headless_brain.py]
2026-06-29 Fix: allow ML to run in debug to update graph, add flush to LINE logs
    [headless_brain.py, line_notifier.py]
2026-07-21 Feat: Make debug page inject realistic fake variance into graph
    [falling.csv, static.csv, walking.csv]
2026-07-21 Fix: Delay simulated Fall status transition until after the variance peak drops to mimic ML state machine
    [headless_brain.py]
2026-07-21 Fix: Temporal median filter to remove router spikes and improve debug fall timing
    [headless_brain.py]
2026-07-21 Fix: Make debug simulation graphs beautifully smooth using sine waves
    [headless_brain.py]
2026-07-21 Fix: Use multiple incommensurate sine waves for organic pseudo-random debug graphs
    [headless_brain.py]
2026-07-21 Fix: Add jitter to sine waves for more organic and realistic debug simulation
    [headless_brain.py]
2026-07-22 Fix: Add smooth linear interpolation between states and reduce peak height in debug simulation
    [headless_brain.py]
2026-07-22 Fix: Scale debug simulation noise and waves relative to user threshold so it doesn't accidentally exceed it
    [headless_brain.py]
2026-07-22 Fix: Rewrite debug sim with hard floor/ceiling so Static/Movement never cross threshold
    [headless_brain.py]
2026-07-22 Fix: Smooth noise accumulator, instant snap on click, lower fall peak, hard zone guarantees
    [headless_brain.py]
2026-07-22 Fix: Reduce noise drift 0.02, lower amplitude, extend fall to 3s for organic look
    [headless_brain.py]
2026-07-22 Fix: Remove lerp from sim states, direct assignment with hard floor/ceiling guarantees
    [headless_brain.py]
2026-07-22 Fix: Harmonic texture for organic bumps, sim_base lerp for smooth amplitude transitions on click
    [headless_brain.py]
2026-08-13 Feat: Phase 5 Physical Alarm Receiver - ESP32 UDP buzzer and LED on fall detection
    [falling.csv, static.csv, walking.csv]
2026-08-13 Fix: Update Phase5 firmware to use ESP32 Core v3 ledcAttach/ledcWriteTone API
    [Phase5_Alarm_Receiver.ino]
2026-08-13 Feat: Phase5 heartbeat system - ESP32 broadcasts alive every 5s, Pi tracks it, dashboard shows Alarm Receiver status card
2026-08-13 Fix: Hide alarm receiver card when no devices connected, appear only when online
    [Phase5_Alarm_Receiver.ino]
2026-08-13 Fix: Remove alarm receiver card from dashboard, fix broadcast_ws not firing bug
    [headless_brain.py]
2026-08-13 Fix: Change alarm receiver port to 5005 to avoid conflict with ROUTER_STIMULUS
    [Phase5_Alarm_Receiver.ino, alarm_broadcaster.py, headless_brain.py]
2026-08-13 Feat: Add persistent Mock Sensor when no hardware is connected to allow simulator testing without physical CSI nodes
2026-08-13 Cleanup: Remove Mock Sensor
2026-08-13 Feat: Phase 6 Combined Node - single ESP32 for CSI and Alarm
2026-08-14 Fix: Delay debug fall alert until graph transition completes
    [headless_brain.py]
2026-08-19 Feat: Continuous alarm siren & LED until button on GPIO 5 is pressed
2026-08-19 Feat: Add continuous siren and LED blink until button on Pin 17 is pressed
2026-08-19 Feat: Phase 7 Combined Node with LINE silence alarm button & /silence endpoint
2026-08-19 Fix: Add missing except block in alarm_broadcaster.py
    [alarm_broadcaster.py]
2026-11-09 feat: Phase 8 alert station, hold-2s SOS button and 3D-printed enclosures
    - Alert Station firmware: ESP32 + active buzzer + LED + button, rings on
    FALL_ALERT / SOS_ALERT UDP broadcasts, silence button, self-test, heartbeat
    - RX node firmware: hold the button 2 s in idle to send SOS to the Pi and
    every Alert Station; short press still silences a fall alarm
    - Pi: SOS handling with its own dedupe window, LINE SOS card, SOS/silence
    broadcasts, dashboard SOS state, new tests (35 pass)
    - PC firmware tests with mocked Arduino/WiFi/UDP (31 pass)
    - Parametric OpenSCAD enclosures with ready-to-print STLs (no supports,
    no brand name), desk stand, optional antenna-hole station base,
    printabili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
